Swapnil55559/BLDC_Driver_and_Program/PCB files/README.md

# BLDC_Driver_and_Program
Board schematics, designs, layout, embedded code for Maxon Flat BLDC driver in AVR C
