Swapnil55559/BLDC_Driver_and_Program/PCB files/brd.png

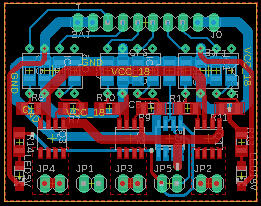
PCB files/brd.png
