Swapnil55559/BLDC_Driver_and_Program/PCB files/sch.png

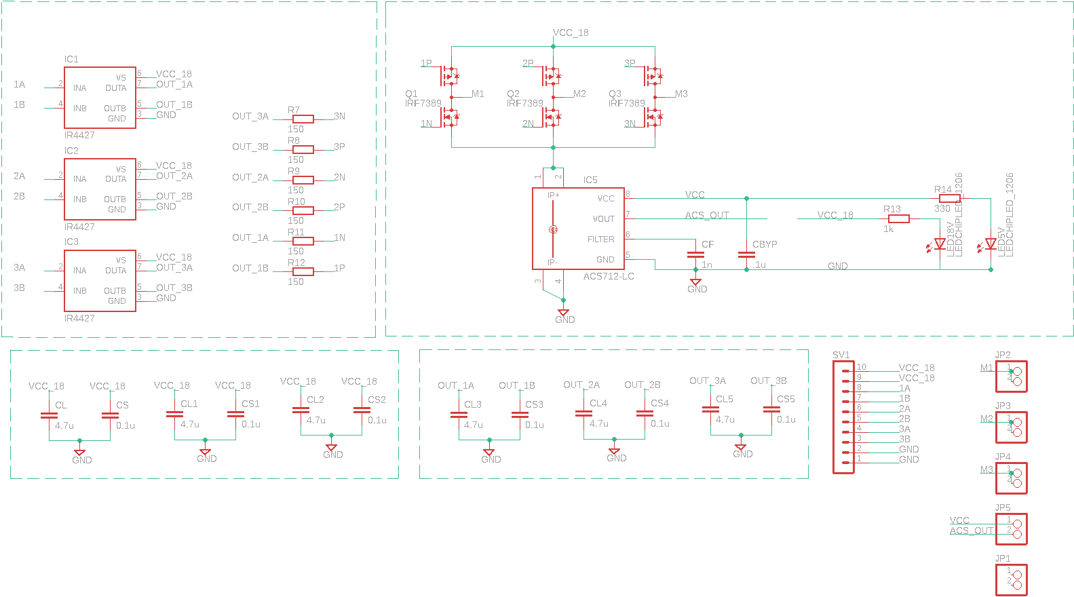
PCB files/sch.png
