Swapnil55559/BLDC_Driver_and_Program/PCB files/motor-driver.brd

## EAGLE design PCB files/motor-driver.brd (2024-01-06)

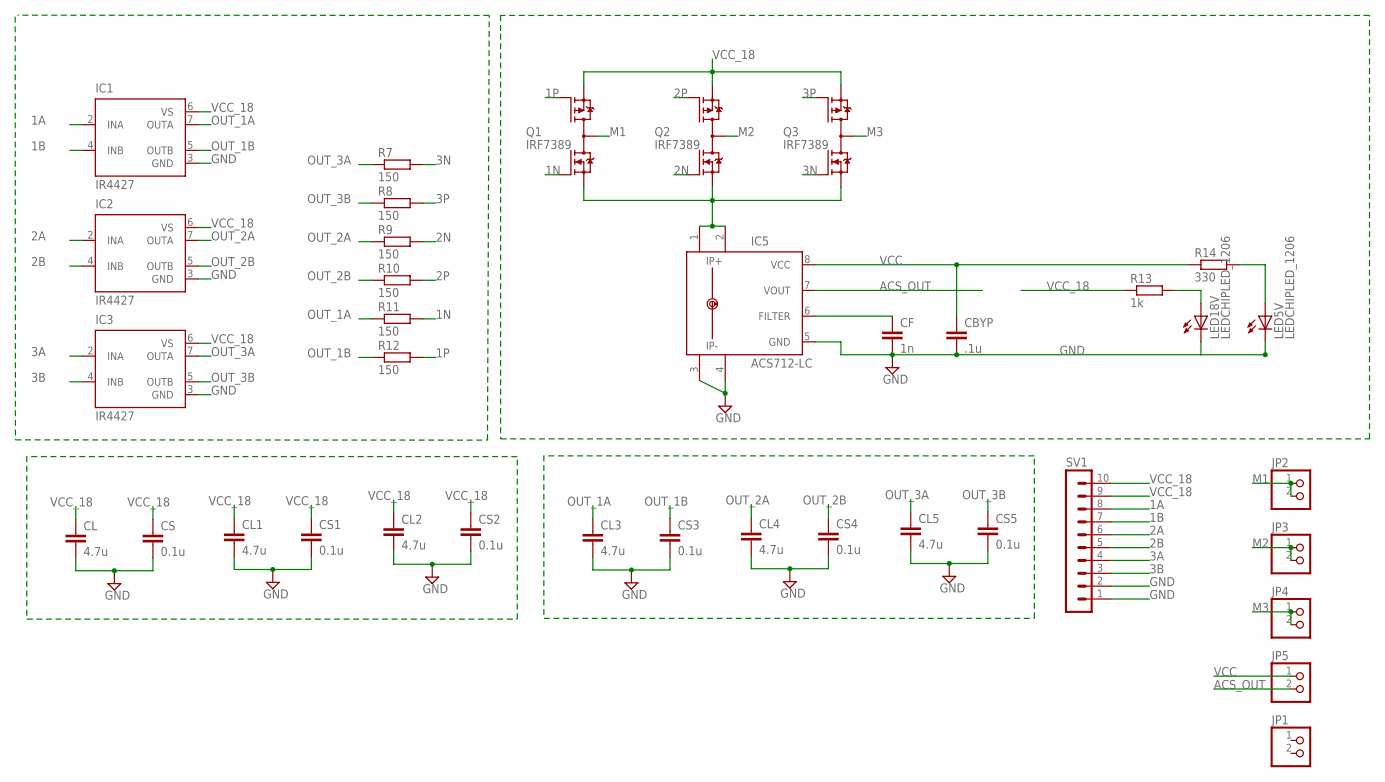
[picture p3: schematic motor-driver.sch]

Parts:
CBYP: .1u; C1206
CF: 1n; C1206
CL, CL1, CL2, CL3, CL4, CL5: 4.7u; C1206
CS, CS1, CS2, CS3, CS4, CS5: 0.1u; C1206
IC1, IC2, IC3: IR4427; DIL08
IC5: ACS712-LC; SOIC8
JP1, JP2, JP3, JP4, JP5: PINHD-1X2; 1X02
LED5V, LED18V: LEDCHIPLED_1206; CHIPLED_1206
Q1, Q2, Q3: IRF7389; SO08-IRF
R7, R8, R9, R10, R11, R12: 150; R1206
R13: 1k; R1206
R14: 330; R1206
SV1: MA10-1

Connections:
1A: IC1.2 (INA), SV1.8
1B: IC1.4 (INB), SV1.7
1N: Q1.2 (N-G), R11.2
1P: Q1.4 (P-G), R12.2
2A: IC2.2 (INA), SV1.6
2B: IC2.4 (INB), SV1.5
2N: Q2.2 (N-G), R9.2
2P: Q2.4 (P-G), R10.2
3A: IC3.2 (INA), SV1.4
3B: IC3.4 (INB), SV1.3
3N: Q3.2 (N-G), R7.2
3P: Q3.4 (P-G), R8.2
ACS_OUT: IC5.7 (VOUT), JP5.2
FILTER_ACS: CF.1, IC5.6 (FILTER)
GND: CBYP.2, CF.2, CL.2, CL1.2, CL2.2, CL3.2, CL4.2, CL5.2, CS.2, CS1.2, CS2.2, CS3.2, CS4.2, CS5.2, IC1.3 (GND), IC2.3 (GND), IC3.3 (GND), IC5.3 (IP-), IC5.4 (IP-1), IC5.5 (GND), LED5V.C, LED18V.C, SV1.1, SV1.2
M1: JP2.1, JP2.2, Q1.5 (D), Q1.6 (D), Q1.7 (D), Q1.8 (D)
M2: JP3.1, JP3.2, Q2.5 (D), Q2.6 (D), Q2.7 (D), Q2.8 (D)
M3: JP4.1, JP4.2, Q3.5 (D), Q3.6 (D), Q3.7 (D), Q3.8 (D)
unnamed: LED18V.A, R13.2
unnamed: LED5V.A, R14.2
OUT_1A: CL3.1, IC1.7 (OUTA), R11.1
OUT_1B: CS3.1, IC1.5 (OUTB), R12.1
OUT_2A: CL4.1, IC2.7 (OUTA), R9.1
OUT_2B: CS4.1, IC2.5 (OUTB), R10.1
OUT_3A: CL5.1, IC3.7 (OUTA), R7.1
OUT_3B: CS5.1, IC3.5 (OUTB), R8.1
SINK: IC5.1 (IP+), IC5.2 (IP+1), Q1.1 (N-S), Q2.1 (N-S), Q3.1 (N-S)
VCC: CBYP.1, IC5.8 (VCC), JP5.1, R14.1
VCC_18: CL.1, CL1.1, CL2.1, CS.1, CS1.1, CS2.1, IC1.6 (VS), IC2.6 (VS), IC3.6 (VS), Q1.3 (P-S), Q2.3 (P-S), Q3.3 (P-S), R13.1, SV1.9, SV1.10

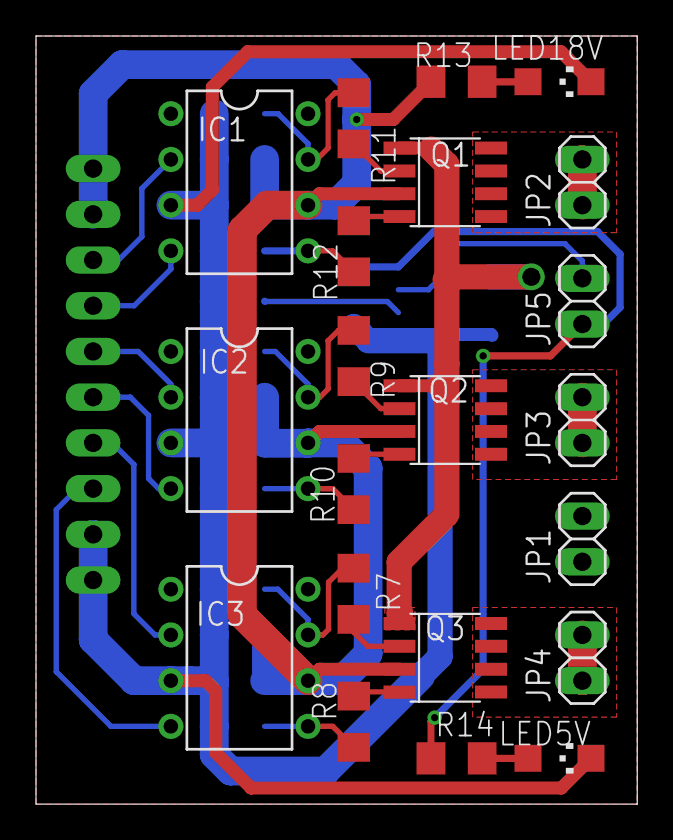
[picture p4: board motor-driver.brd from above]

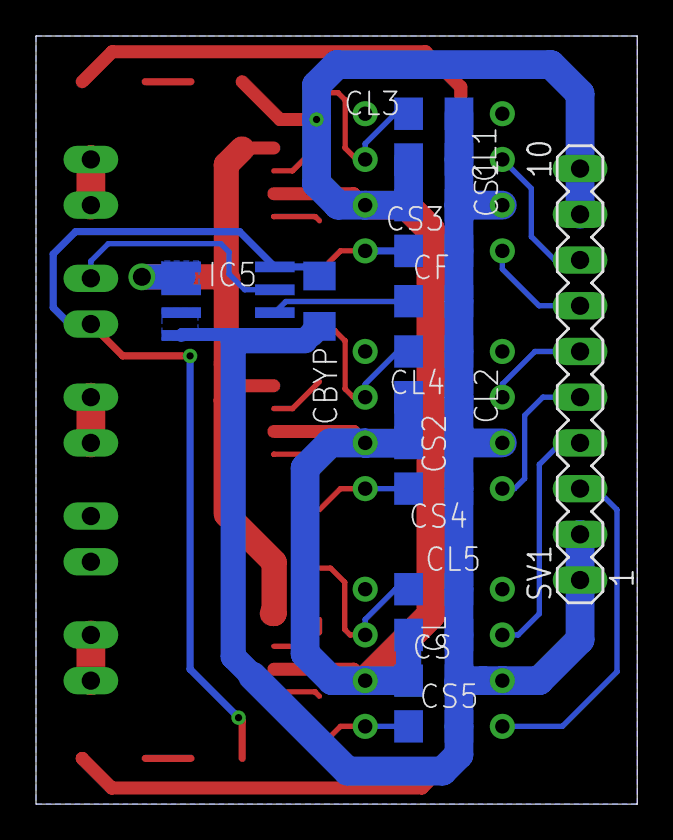
[picture p5: board motor-driver.brd from below]

Board: 2 copper layers, 33.4 x 42.7 mm, 37 parts (16 on the bottom side), 29 nets.
